rynbrd/r51-ecu/ecus/bridge/Config.h

#ifndef _R51_BRIDGE_CONFIG_H_
#define _R51_BRIDGE_CONFIG_H_

// Uncomment the following line to enable debug output on serial and/or the
// interactive console.
#define DEBUG_ENABLE
#define CONSOLE_ENABLE

// Serial configuration for the debug console.
#define SERIAL_DEVICE Serial
#define SERIAL_BAUDRATE 115200
#define SERIAL_WAIT false

// Resolution of analogRead return value.
#define ARDUINO_ANALOG_RESOLUTION 4096

// CAN hardware configuration.
#define MCP2515_CS_PIN 9
#define MCP2515_IRQ_PIN 11
#define MCP2518_CS_PIN 12
#define MCP2518_IRQ_PIN 13

// Multicore buffer settings.
#define IO_CORE_BUFFER_SIZE 32
#define PROC_CORE_BUFFER_SIZE 16

// Vehicle CAN bus mode and speed. This is CAN 2.0 at 500K for the R51.
#define VEHICLE_CAN_MODE Canny::CAN20_500K
#define VEHICLE_READ_BUFFER 16
#define VEHICLE_WRITE_BUFFER 2

// Uncomment to enable J1939 on boards that support it.
#define J1939_ENABLE
#define J1939_ADDRESS 0x18
#define J1939_NAME 0x000013B000FFFAC0
#define J1939_PROMISCUOUS true
#define J1939_CAN_MODE Canny::CAN20_250K
#define J1939_READ_BUFFER 32
#define J1939_WRITE_BUFFER 2

// Uncomment the following line to enable rear defrost control.
#define DEFROST_HEATER_ENABLE
#define DEFROST_HEATER_PIN 24
#define DEFROST_HEATER_MS 300

// Uncomment the following line to enable steering keypad.
#define STEERING_KEYPAD_ENABLE
#define STEERING_KEYPAD_ID 0x00
#define STEERING_KEYPAD_ENABLE
#define STEERING_PIN_A A1
#define STEERING_PIN_B A2
#define STEERING_DEBOUNCE_MS 20

// Uncomment to enable Bluetooth via SPI.
#define BLUETOOTH_ENABLE
#define BLUETOOTH_DEVICE_NAME "R51 Controls"
#define BLUETOOTH_SPI_CS_PIN 22
#define BLUETOOTH_SPI_IRQ_PIN 23
#define BLUETOOTH_UPDATE_MS 1000

// RealDash configuration. RealDash uses the BLE connction and is enabled
// automatically when BLE is configured above.
#define REALDASH_FRAME_ID 0x10
#define REALDASH_HB_ID 0x20
#define REALDASH_HB_MS 500

#endif  // _R51_BRIDGE_CONFIG_H_
