rynbrd/r51-ecu/ecus/bridge/Debug.h

#ifndef _R51_BRIDGE_DEBUG_H_
#define _R51_BRIDGE_DEBUG_H_

#include "Config.h"
#include <Arduino.h>

#if defined(DEBUG_ENABLE) && defined(SERIAL_DEVICE)

#define D(x) x

#define DEBUG_MSG(MSG) ({\
    SERIAL_DEVICE.println(MSG);\
    SERIAL_DEVICE.flush();\
})
#define DEBUG_MSG_VAL(MSG, VAL) ({\
    SERIAL_DEVICE.print(MSG);\
    SERIAL_DEVICE.println(VAL);\
    SERIAL_DEVICE.flush();\
})
#define DEBUG_MSG_OBJ(MSG, OBJ) ({\
    SERIAL_DEVICE.print(MSG);\
    (OBJ).printTo(SERIAL_DEVICE);\
    SERIAL_DEVICE.println();\
    SERIAL_DEVICE.flush();\
})
#define DEBUG_MSG_FMT(MSG, VAL, FMT) ({\
    SERIAL_DEVICE.print(MSG);\
    SERIAL_DEVICE.println(VAL, FMT);\
    SERIAL_DEVICE.flush();\
})

#else

#define D(x)

#define DEBUG_MSG(MSG)
#define DEBUG_MSG_VAL(MSG, VAL)
#define DEBUG_MSG_VAL_FMT(MSG, VAL, FMT)

#endif  // DEBUG_ENABLE && SERIAL_DEVICE

#endif  // _R51_BRIDGE_DEBUG_H_
