rynbrd/r51-ecu/(commit log)

2021-10-21 Add connector pinouts for AV Control Unit.
2021-10-21 Add image to identify AV connector.
2021-10-21 Add housing parts. Remove extra pinout columns.
2021-10-21 Add harness for antenna plug.
2021-10-22 Add basic CAN framework and simple scanner implementation for testing.
2021-10-24 Wire up dashboard status.
2021-10-26 Update wiring and pinout information.
2021-10-26 Add FrameListener interface. Generalize ino file more.
2021-10-26 Add dash frame listener.
2021-10-28 Fix vehicle frame length checking.
2021-10-28 Log error on invalid realdash frame receive.
2021-10-31 Combine RealDash into one class to accomodate its unique approach.
    RealDash does not allow the clean separation of state and command
    frames. When RealDash modifies state it does so by sending the same
    frame it receives.
2021-10-31 Clean up debug messaging. Memory footprint was borderline with debug enabled.
2021-11-01 Add support for RealDash 0x66 frames and prefer them for writes.
    The 0x44 RealDash frame does not include a checksum when sending to
    RealDash. This harms realibility on flakey connections.
2021-11-01 Add CAN "listen only" mode to disalbe writes to CAN bus.
2021-11-02 Repeat RealDash frames on each update.
    This ensures RealDash receives state changes, particularly on start-up
    when the serial port is just connecting and may not be aligned with the
    read side of the protocol.
2021-11-02 Generalize the frame receiver implementation.
2021-11-02 Don't log error when no CAN frame available.
2021-11-03 Fix filling of first byte in frame 0x540.
2021-11-03 Use appropriate bytes for RealDash temperature control.
2021-11-03 Split RealDash into controller and listener.
    Rethinks the RealDash communication protocol - again. As I learn more
    about RealDash I'm able to accomplish more with it. I've chosen to move
    back to the standard CAN way of things - only one system sends frames of
    a given ID. Frames are sent on an "at least once" basis. The protocol
    gracefully handles receiving the same packet multiple times.
2021-11-03 Support incremental temperature changes.
    This forces the vehicle climate controller and listener to be combined
    as the listener needs to know the current state of the A/C Auto Amp in
    order to know what the new temperature is when
    incrementing/decrementing. It's also necessary to avoid taking the A/C
    auto amp out of dual mode if the wrong commands are sent.
2021-11-03 Clean up temperature state code.
2021-11-03 Remove side mirror defrost controls.
    There is no way to control the side mirror heating elements
    independently of the rear window heater.
2021-11-03 Use frame timeout to reset RealDash control state.
2021-11-04 Use 8 bytes for internal RealDash frames to avoid gotchas.
2021-11-04 Fix fan speed bug and clean up logging in RealDashClimate.
2021-11-05 Update docs for correct operation of temperature control.
2021-11-05 Update climate temperature control functionality.
    Control frames do not set temperatures directly. Rather, incremental
    changes are sent to adjust the state stored in the AC Auto Amp. #
    Please enter the commit message for your changes. Lines starting
2021-11-08 Update ClimateController interface to simulate button clicks.
2021-11-08 Update climate docs with outside temperature value.
2021-11-08 Add support for outside temperature state.
2021-11-10 Log dropped CAN frames on write.
2021-11-10 Use contstant frame types for settings.
2021-11-10 Add settings command to retrieve current state.
2021-11-10 Define RealDash settings frames.
2021-11-11 Add missing values for settings state frame documentation.
2021-11-11 Fix connectors image.
2021-11-12 Add support for filtering CAN packets.
2021-11-12 Check interrupt pin for CAN frame availability.
2021-11-12 Filter out unused frames.
2021-11-12 Fix CAN frame filtering.
    [controller.ino]
2021-12-20 Fix (remove) SAME51 CAN filtering.
    [controller.ino]
2021-12-20 Send state on temperature change.
2022-01-15 Add sketch to test steering switches.
2022-01-16 Adjust steering switch analog values.
2022-01-17 Set last_write to properly trigger dash frame resends.
2022-01-17 Add steering switch listener.
2022-01-17 Wire up steering wheel switches.
2022-02-07 Reimplement steering wheel keypad as bus node.
2022-02-07 Allow node receive calls to emit multiple frames.
2022-02-08 Add function to initialize frames.
2022-02-08 Document climate control display units in state frames.
2022-02-08 Add filtering to mock broadcast implementation.
2022-02-09 Support filtering in broadcast mock.
2022-02-09 Debug prints take frame structs.
2022-02-09 Add climate control frame tests. Fix some bugs.
2022-02-09 Split climate tests into control and state tests. Improve frame assertions.
2022-02-13 Make Node::filter const.
2022-03-30 Fix standalone sketch when debug disabled.
    [standalone.ino]
2022-03-30 Revert my serial_text mistake.
    [standalone.ino]
2022-04-01 CanNode takes a CANBed::Controller pointer. CanNode no longer has a begin() method. The controller should have its begin method called in setup.
    [standalone.ino]
2022-04-02 Replace internal bus with Caster. This is literally the same thing but generalized with templates.
    [standalone.ino]
2022-04-02 Update ArduinoCaster.
2022-04-03 Replace CANBed with Canny.
    [standalone.ino]
2022-04-11 Replace internal Frame struct with Canny::Frame.
    [standalone.ino]
2022-04-11 Update ArduinoFaker to fix memory bug.
2022-04-11 Make steering buttons value types.
2022-04-13 Frame construction nit.
2022-04-14 Pull fixed ArduinoCanny and ArduinoNissanR51 libraries.
2022-04-18 Add read/write filtering to edge nodes.
2022-04-20 Replace ArduinoNissanR51 with ArduinoR51Vehicle.
2022-04-20 Add ArduinoR51Test to libraries.
2022-08-31 Clean up Message printables.
2022-08-31 Add string matcher and fix printables matcher name.
2022-09-01 Console supports sending CAN frames.
2022-09-01 Add BLE node to bridge. Wire up BLE connection events.
2022-09-01 Fix climate not yielding init frames.
2022-09-02 Wire in console node to bridge.
2022-09-02 Add CAN ID filtering to console module.
2022-09-02 Implement tire request state event.
2022-09-02 Implement engine temperature state request.
2022-09-02 Fix switch case warning in tire pressure node.
2022-09-02 Remove debug print from bluetooth node.
2022-09-03 Add tire pressure node to bridge.
2022-09-03 Support persisting tire position configuration.
2022-09-04 Bridge doesn't filter tire pressure frames.
    [CAN.h]
2022-09-04 Fix RP2040 config store bugs.
    [bridge.ino]
2022-09-05 Move filtering to CAN connection.
2022-09-05 Rename RP2040.h -> Pico.h and fix core idling.
2022-09-07 Do CAN filtering in buffered node.
2022-09-08 Do filtering and buffering at the CAN connection level.
2022-09-26 Print J1939 address claims to console.
2022-09-26 ECM, IPDM, and Tire nodes yield in handler.
2022-09-26 Fusion supports stereo discovery and power state.
2022-09-28 Implement audio display availability and power.
2022-09-29 Don't display switch to volume page when on splash page.
2022-09-29 Don't display track times when not playing.
2022-09-29 Remove debug prints.
2022-09-29 Refresh header on device connectivity. Change HMI device var name.
2022-10-01 Add initial controller support for Adafruit rotary encoders.
2022-10-01 Implement interrupts in RotaryEncoderGroup. Add docs to class. Clean up setting of LDE colors.
2022-10-04 Fix brightness for rotary encoder.
2022-10-11 Follow conventions for Tire event and class names.
2022-10-12 SteeringKeypad emits regular keypad events.
2022-10-12 Keypad keys, encoders, and LEDs are independent.
2022-10-14 Add some button funtionality.
2022-10-14 Handle encoder keypad events in HMI.
2022-10-14 Wire up steering audio controls.
2022-10-14 Use correct tire node in monitor sketch.
2022-10-14 Handle HMI defog and defrost buttons.
2022-10-14 Correct naming of defog/defrost.
    [Config.h, bridge.ino]
2022-10-14 Add POWER subsystem and events.
2022-10-14 Fix power and keybox implementation.
2022-10-15 Add power control support.
2022-10-15 Handle power state changes in HMI.
2022-10-15 Support keypad LED blink modes.
2022-10-15 Blink keypad LED on power fault.
2022-10-15 Fix bridge defrost def check.
    [bridge.ino]
2022-10-17 Fix printing of unsigned 64-bit integers. Some Arduino hardware packages lack the appropriate print overloads.
2022-10-17 Move defrost activation to BCM subsystem. Defrost is controlled via a wire connected to the BCM.
2022-10-17 Move tire management to BCM. Tire monitoring occurs in the BCM.
2022-10-17 Add BCM illum node to bridge. And fix tire pressure node.
    [bridge.ino]
2022-10-17 J1939 adapter does filtering in route method.
2022-10-17 LED indicators are 100% bright by default.
2022-10-17 Fix Blink argument ordering.
    [controller.ino]
2022-10-17 Fix power control triggering on press and release.
2022-10-17 Fix keypad LED alt blink mode.
2022-10-17 Handle illum event in power controls.
2022-10-17 Remove debug prints from RotaryEncoder.
2022-10-17 Filter power events in HMI by PDM.
2022-10-17 Fix HMI climate button mappings.
2022-10-17 Fix HMI power/sleep modes. The HMI device does not update state in sleep mode, so instead we fake "sleep" by turning off the backlight.
2022-10-18 Nav encoders bring display out of sleep.
2022-10-18 Right encoder toggles seek mode on press.
2022-10-18 Use Fusion heartbeat in power signal.
2022-10-18 Fix up HMI audio buttons.
2022-10-18 HMI doesn't change audio pages when Fusion powered off.
2022-10-18 Fusion waits for all events before powering on.
2022-10-20 Move audio long press power button to left.
2022-12-11 Use trivial union members to fix MessageValue variant.
    [CAN.h, Debug.h, J1939.h]
2022-12-18 Rename libraries/Common to Core.
    This interferes with the Common.h in pico core.
    [J1939.h, standalone.ino]
2022-12-18 Fix typo and include in console check.
    [standalone.ino]
2022-12-19 Don't filter events in bridge pipe. Don't start serial because RP2040.
2022-12-19 Add missing console node in standalone ECU. ...and clean up some includes.
    [J1939.h, standalone.ino]
2022-12-19 Add RP2040 watchdog timer to all ECUs.
2023-01-07 Add config for CAN interrupt pins. Document that we target the older version of the CANBed Dual.
2023-01-07 Fix README link to Pico Core.
2023-01-08 Enable hardware filtering on vehicle CAN.
2023-01-08 J1939Adapter filters messages from self.
2023-01-08 Forward power state events to I/O core.
2023-01-08 Remove unused PowerEvent FAULT_STATE.
2023-01-08 Actually attach rotary encoder ISR in standalone.
2023-01-08 Forward rotary encoder control keypad events.
2023-01-09 Console pretty-prints climate state.
2023-01-09 Pretty print BCM and IPDM state to console.
2023-01-09 Pretty print keypad state on console.
2023-01-10 Earle's Pico core doesn't work as the pin defs are incorrect.
    [bridge.ino, controller.ino, standalone.ino]
2023-01-10 Add missing newline to DEBUG_MSG_OBJ.
    [Debug.h]
2023-01-11 Adjust steering keypad for 1k pull-up resistor. Also ensure keypad does not issue a ghost signal on boot.
    [Config.h]
2023-01-11 Use open drain to trigger defrost pin.
2023-01-11 Document steering and defrost resistor requirements in README.
2023-01-14 Add rotary encoder test tool.
2023-01-14 Update ECU sketches with the I2C learnings.
2023-01-14 Pretty print bluetooth state to console.
2023-01-14 Move switch test tool under tools.
2023-01-14 Add I2C scanner.
2023-01-14 Controllers set Bluetooth name on boot. Also use correct pins for Bluetooth.
    [Config.h, bridge.ino, standalone.ino]
2023-01-15 Remove print statements from Pipe.
2023-01-15 Move steering gpio setup to begin method.
2023-01-15 Remove debug prints from MomentaryOutput.
2023-01-15 Fix MCP2518 frame data overruns.
2023-01-16 Set SPI CS pins low to avoid conflicts during setup.
    [bridge.ino, controller.ino, standalone.ino]
2023-01-16 Catch default case in HMI PDM integration.
2023-01-16 Pretty print power events to console.
2023-01-16 Fix pdm and keypad settings.
    [Config.h]
2023-01-16 Do not use system interrupts for rotary encoders.
2023-01-16 Consistently name IRQ pin config defs.
2023-01-17 Update HMI button map.
2023-01-17 swap MCP2515 and MCP2518 between CAN and J1939. The Fusion messages come too fast and the MCP2515 doesn't have a large enough receive buffer to handle them. The MCP2517FD on the CANBed Dual can be co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
    [CAN.h, J1939.h]
2023-01-22 Use correct resistor value for steering switches and fix switch button mapping. We were accidentally using a 10k resistor in previous testing.
    [analog_switch.ino]
2023-01-22 Add M98 connector pinout docs. This has the defrost heater pin and internal AV CAN bus pins.
2023-01-23 Fix pipe overflow message in standalone.
    [Pipe.h]
2023-01-23 Clear HMI device connectivity on Fusion power off.
2023-01-23 Re-enable heartbeat timer after boot.
2023-01-24 Don't send state request on regular power on. This actually causes the stereo to power off.
2023-01-24 Add Fusion power on mode. This allows us to differentiate between unit init and regular power on.
2023-01-26 Add missing CAN-L pin for M98 conector.
2023-01-26 Fix climate fan display.
2023-02-02 Don't cancel tire swap on screen refresh.
2023-02-02 Send current volume when inc/dec puts it out of range.
2023-02-03 Add button tests to Controls library.
2023-02-03 Add steering tests to Controls library.
2023-02-03 Fix short press on repeating buttons.
2023-02-03 Do not use ticker for button controls.
2023-02-03 Tweak steering switch thresholds.
2023-02-03 Clamp fan speed to max value.
2023-05-26 Update power pins to match wiring.
2023-05-27 Fix Keybox PWM pin assignments.
2023-05-27 Revert "Fix Keybox PWM pin assignments."
    This reverts commit dd8c6c36e60de6ed7c8ff5d8a990e76baed17594.
2023-05-27 Fix pin mapping. We use zero indexing.
2023-05-28 Make steering switch debounce and resolution configurable. Also fix resolution for RP2040.
    [Config.h, analog_switch.ino, bridge.ino, standalone.ino]
2023-08-22 Remove Fusion heartbeat timer.
    Previously the Fusion library would reset state if a message was not
    received from the Fusion head unit. This was sometimes triggered by
    accident. However, the feature is not needed as the head unit is not
    expected to be removed from the vehicle while the vehicle is powered
    on so it should never enter into an UNAVAILABLE state.
2023-08-23 Controls: Nav button long press loads home page.
